MOHAMED141414/sscs2026-conv-accel/docs/figures/fig_fsm_same.png

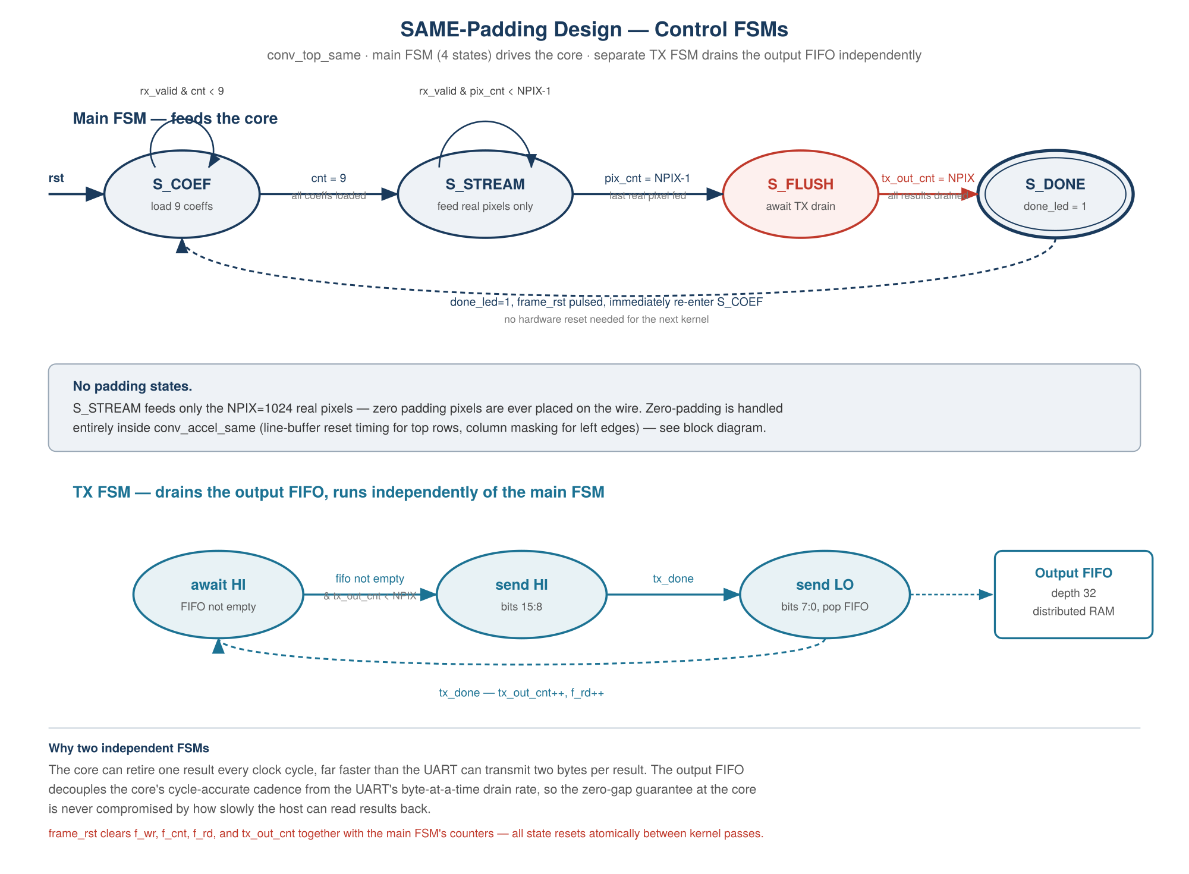
docs/figures/fig_fsm_same.png
