MOHAMED141414/sscs2026-conv-accel/docs/figures/waveform_first_output.png

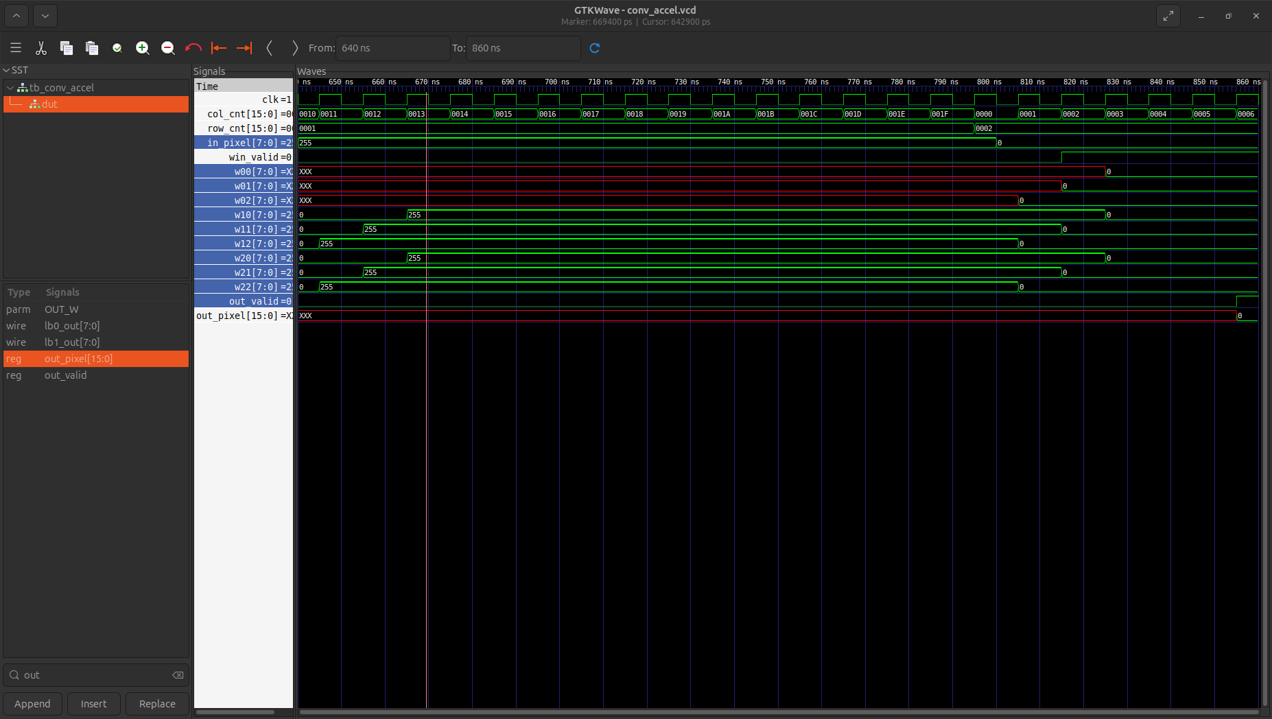
docs/figures/waveform_first_output.png
