MOHAMED141414/sscs2026-conv-accel/docs/figures/waveform_saturation.png

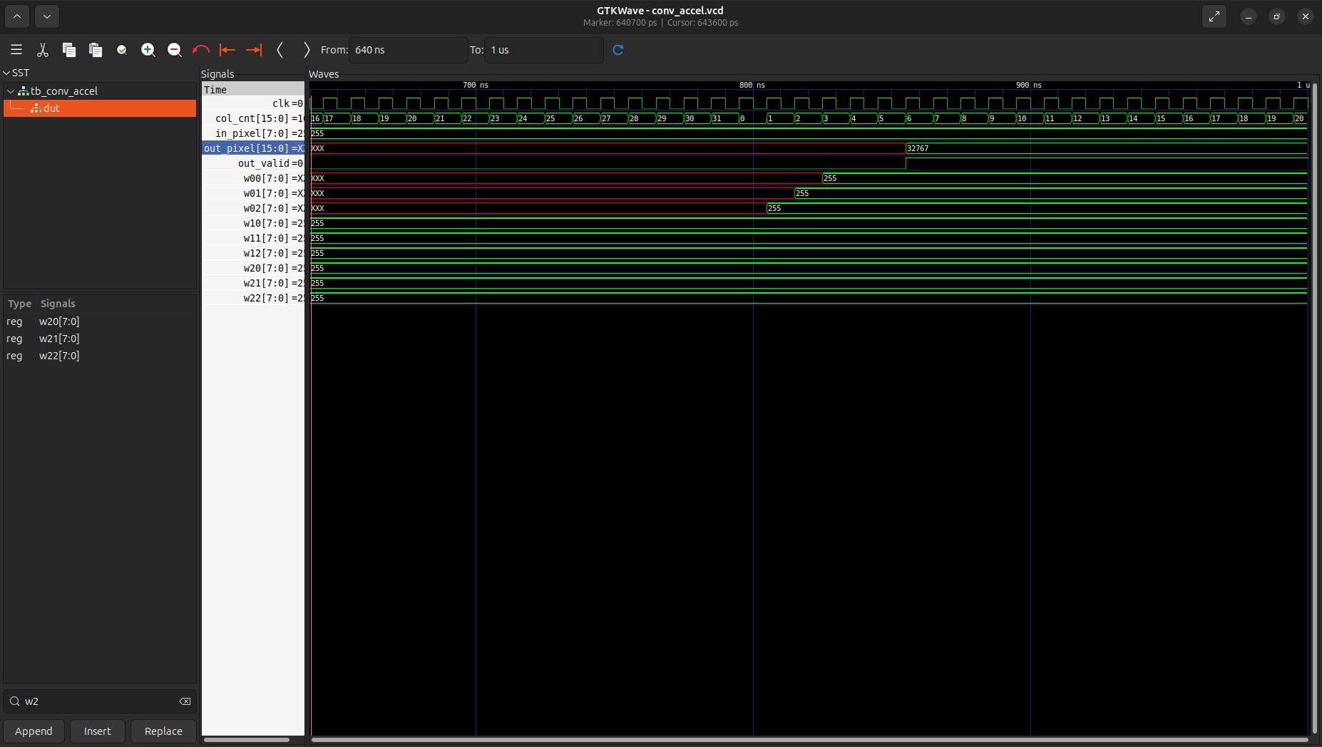
docs/figures/waveform_saturation.png
