MOHAMED141414/sscs2026-conv-accel/(commit log)

2026-08-18 Multi-kernel support: FSM loops S_DONE->S_COEF, frame_rst between passes
2026-08-27 Fix multi-driver f_cnt (illegal in synthesis, tolerated by simulation) - consolidate FIFO count into single always block
    [conv_top_same.v]
2026-08-27 Fix declare-before-use ordering for tx_lo_phase/tx_sent (XST HDL compiler stricter than Icarus)
    [conv_top_same.v]
2026-09-12 Add SAIF-based power methodology (100% net-matched, post-route): VALID 472.27mW measured, FoM recomputed for both builds
2026-09-12 Remove empty/incomplete SAME SAIF artifact; VALID's measured power stands as the documented representative figure for both builds
2026-09-12 Sync presentation with measured SAIF power figures (472.27mW, FoM 2.417e-3/2.393e-3)
